jimbruges/this-fish-does-not-exist/images/front-angle.jpg

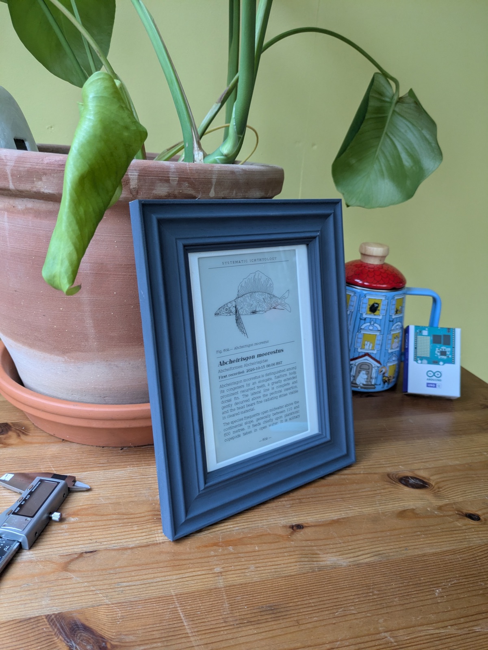
images/front-angle.jpg
