jimbruges/this-fish-does-not-exist/images/outdoors-rear.jpg

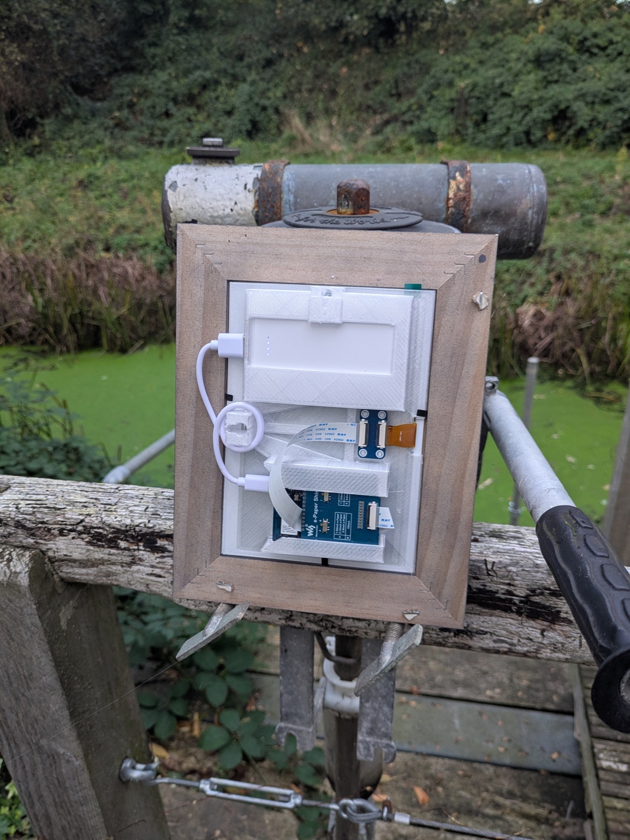
images/outdoors-rear.jpg
