jimbruges/this-fish-does-not-exist/3d-print/front-plate-0.15mm.3mf

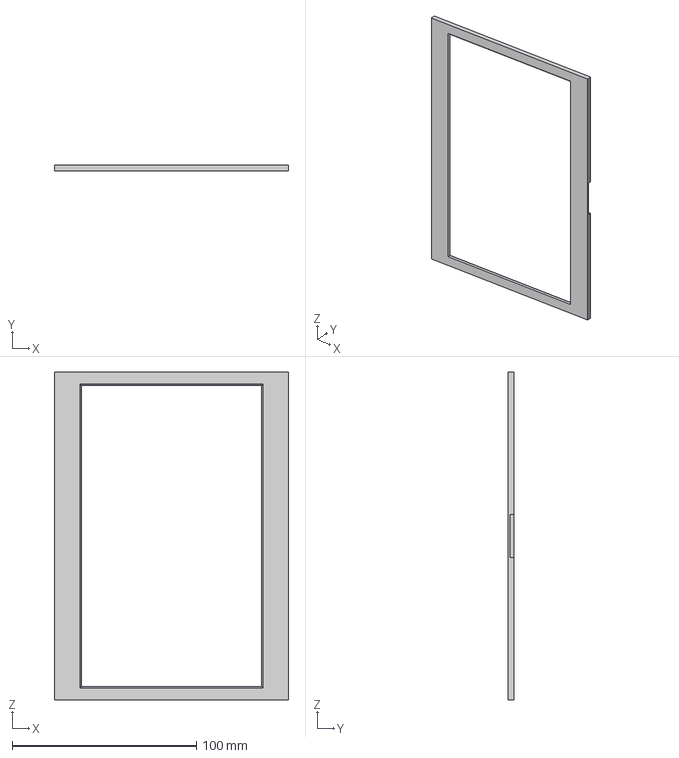
[picture p12: CAD file, 2026-10-15]
3d-print/front-plate-0.15mm.3mf
127.0 x 3.20 x 178.0 mm
