jimbruges/this-fish-does-not-exist/3d-print/mounting-parts.stl

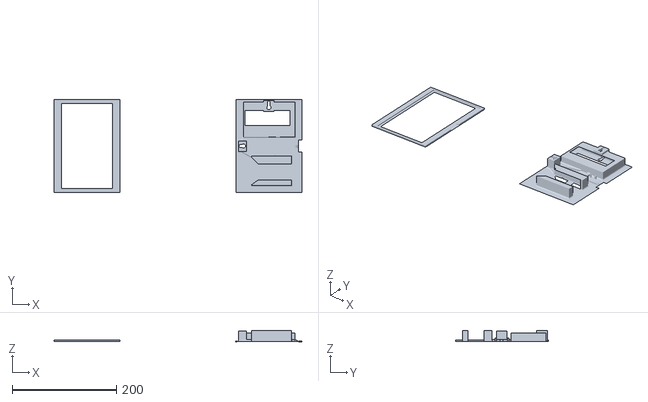
[picture p13: CAD file, 2026-10-15]
3d-print/mounting-parts.stl
476.9 x 178.0 x 21.6
