jimbruges/this-fish-does-not-exist/3d-print/rear-plate-0.25mm-supports.3mf

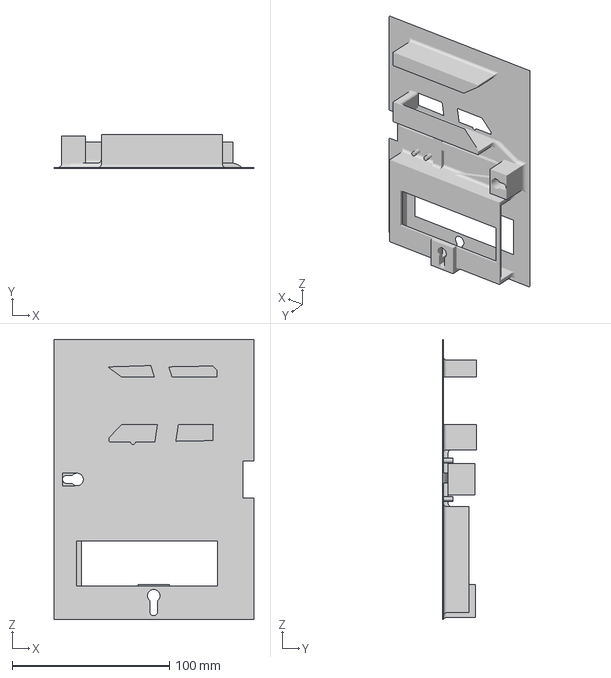
[picture p14: CAD file, 2026-10-15]
3d-print/rear-plate-0.25mm-supports.3mf
127.0 x 21.6 x 178.0 mm
