jimbruges/this-fish-does-not-exist/3d-print/print-settings/front-plate.png

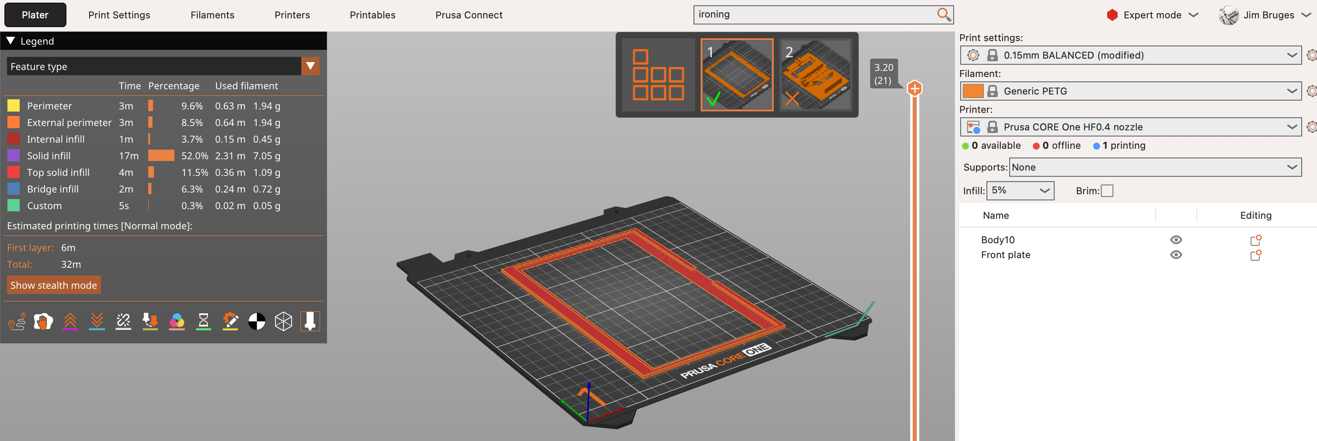
3d-print/print-settings/front-plate.png
