jimbruges/this-fish-does-not-exist/3d-print/print-settings/rear-plate.png

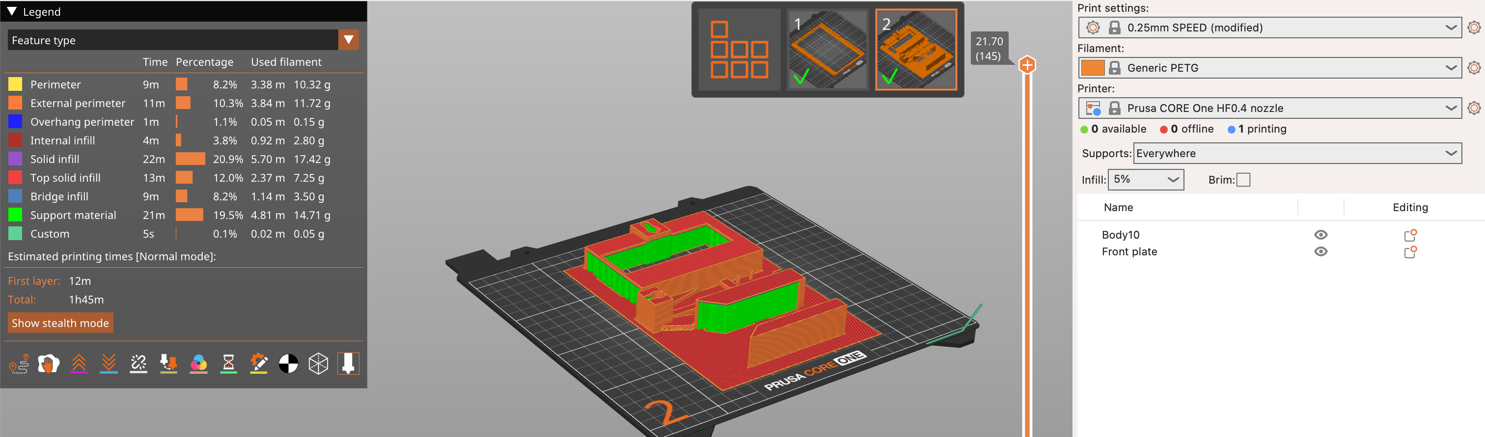
3d-print/print-settings/rear-plate.png
