jimbruges/this-fish-does-not-exist/(commit log)

2026-10-15 Add 3D print files, build photos, BOM and assembly notes
    [front-plate-0.15mm.3mf, mounting-parts.stl, rear-plate-0.25mm-supports.3mf]
2026-10-15 Note that the app was built with Agent Mode in Arduino App Lab
